Tironzi/cc2538_dev_board-main/Real_image_1.jpg

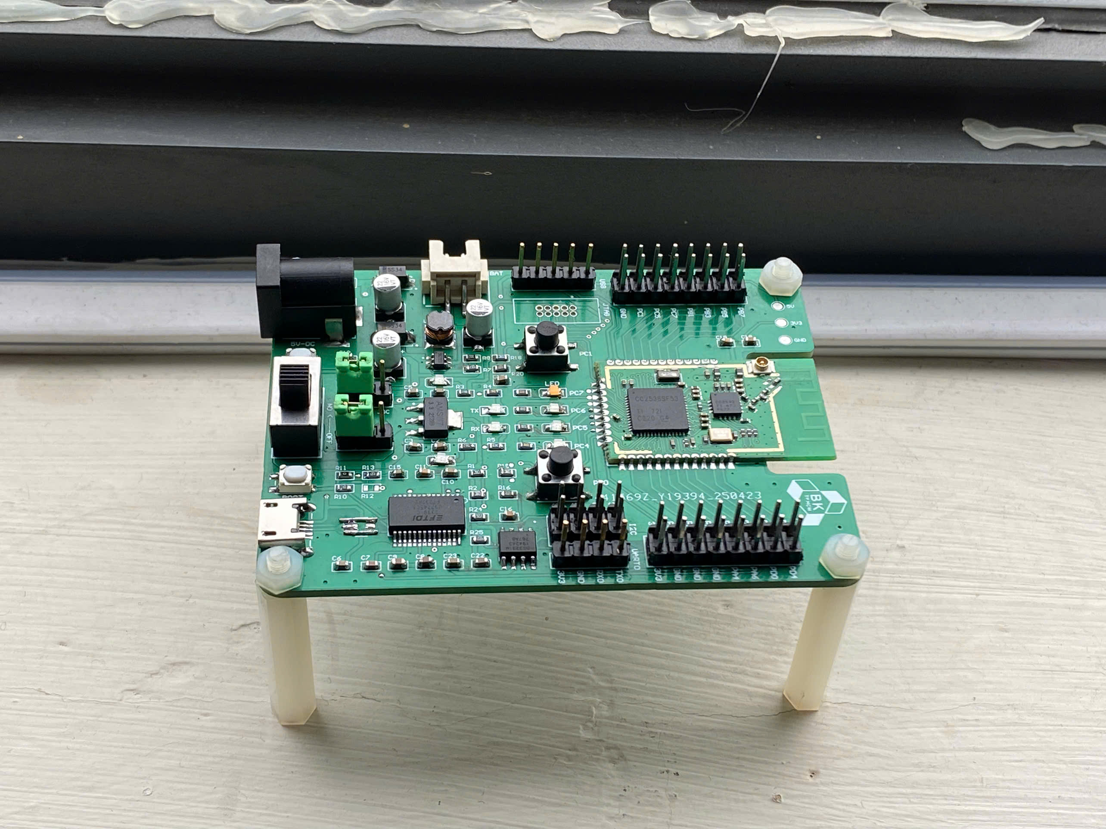
Real_image_1.jpg
