Tironzi/cc2538_dev_board-main/README.md

PROJECT DESIGN IOT HARDWARE

IoT application design and development
