Tironzi/cc2538_dev_board-main/BOM.xlsx

Comment | Description | Designator | Footprint | LibRef | Quantity
BU2032SM-BT-GTR | Battery Holder (Open) Coin, 20.0mm 1 Cell SMD (SMT) Tab | BT2 | BAT_BU2032SM-BT-GTR | BU2032SM-BT-GTR | 1 | chưa có | https://www.thegioiic.com/bs-6-de-pin-cr2032-cr2025-dan-smd
22uF | V-Chip, D4 x H5.5mm, 22uF, 16V | C1, C13, C14 | WCAP-ASLI_D4H5.5 | 865080340003 | 3 | có
1uF | CAP, size 0603, 1uF | C2, C4, C12, C18, C22, C23 | CAP_0603 | 01060310510 | 6 | chưa có | https://www.thegioiic.com/tu-gom-0603-1uf-16v
100nF | CAP, size 0603, 100nF | C3, C5, C6, C7, C9, C11, C15, C16, C17, C19 | CAP_0603 | 01060310410 | 10 | chưa có | https://www.thegioiic.com/tu-gom-0603-100nf-0-1uf-25v
4.7uF | CAP, size 0603, 4.7uF | C8, C10 | CAP_0603 | 01060310410 | 2 | chưa có | https://www.thegioiic.com/tu-gom-0603-4-7uf-10v
D Schottky | Schottky Diode | D1 | SS34 | D Schottky | 1 | có
LED SMD | LED | D2, D3, D4, D5 | LED_0805_YELLOW | LED SMD | 4 | chưa có | https://www.thegioiic.com/led-vang-0805-dan-smd-trong-suot-harvatek
SS34 | Schottky Diode, SS34 | D6 | SS34 | D Schottky | 1 | chưa có | https://www.thegioiic.com/ss34-sma-diode-schottky-3a
GREEN LED | LED | D7 | LED_0805_BLUE | LED SMD | 1 | chưa có | https://www.thegioiic.com/led-xanh-duong-0805-dan-smd-trong-suot-harvatek
RED LED | LED | D8 | LED_0805_RED | LED SMD | 1 | chưa có | https://www.thegioiic.com/led-do-0805-dan-smd-trong-suot-harvatek
BLUE LED | LED | D9 | LED_0805_PINK | LED SMD | 1 | chưa có | https://www.thegioiic.com/led-hong-0805-dan-smd-trong-suot-harvatek
PINK LED | LED | D10 | LED_0805_GREEN | LED SMD | 1 | chưa có | https://www.thegioiic.com/led-xanh-la-0805-dan-smd-trong-suot-harvatek
6V 500mA | 0805L050WR Cầu Chì Tự Phục Hồi 0805 6V 500mA | F1 | PCBComponent_1 | 0805L050WR | 1 | chưa có | https://www.thegioiic.com/0805l050wr-cau-chi-tu-phuc-hoi-0805-6v-500ma
629105150521 | Micro USB 2.0 Type B Receptacle WR-COM, Horizontal, SMT, with Pegs, High Current at Pin 1 & Pin 5 | J1 | 629105150521 | 629105150521 | 1 | có
JST 1x2 | Đầu XH2.54mm 2 Chân Dán SMD Nằm Ngang | J2 | XH 2,54M-2 SMT | JST 2.54mm 1x2 SMT | 1 | chưa có | https://www.thegioiic.com/dau-xh2-54mm-2-chan-dan-smd-nam-ngang
Jack DC | Jack DC input | JDC1 | DC-IN | Jack DC | 1 | có
Jumper | Cắm | JP1, JP5 | JP 1x3 DT | JP 1x3 2.54 Duc Thang | 2 | chưa có | https://www.thegioiic.com/jumper-2-54mm-ngan-mach-6-5mm-mau-xanh-la
JP 1x5 2.54 | Cắm | JP2 | JP 1X5 DT | JP 1x5 2.54 Duc Cong | 1 | có
JP 1x4 2.54 | Cắm | JP3 | JP 1X4 DT | JP 1x4 2.54 Duc Cong | 1 | có
JP 2x4 2.54 | Cắm | JP4 | JP 2X4 DT | JP 2x4 2.54 Duc Cong | 1 | có
JP 2x8 2.54 | Cắm | JP6, JP7 | JP 2x8 DT | JP 2x8 2.54 Duc Thang | 2 | chưa có | https://www.thegioiic.com/hang-rao-duc-doi-2-54mm-80-chan-2-hang-cao-11-2mm-xuyen-lo
22µH | WE-PD2A SMT Power Inductor, size CD43, 22µH | L1 | WE-PD2A_4532 | CD43 INDUCTOR | 1 | chưa có | https://icdayroi.com/cuon-cam-22uh-cd43 | IC đây rồi
62701021621 | WR-BHD Male Box Header, THT Straight, pitch 1.27mm, 2 row, 10 pin | P1 | 62701021621 | 62701021621 | 1 | Chưa có | https://dientuachau.com/idc-male-10p-1-27mm-1#2 | Quận 10
10k | RES, 10K Ohm, size 0603, 5%, RES, 10k Ohm, size 0603, 1% | R1, R2, R15, R18 | resistor_0603 | 0006032525, 0006031031 | 4 | có
2.5k | RES, 2.5K Ohm, size 0603, 5% | R3, R4, R5 | resistor_0603 | 0006032525 | 3 | có
5.6k | RES, 5.6k Ohm, size 0603, 1% | R6 | resistor_0603 | 0006035621 | 1 | có
22k | RES, 22k Ohm, size 0603, 1% | R7 | resistor_0603 | 0006035621 | 1 | chưa có | https://www.thegioiic.com/dien-tro-22-kohm-0603-1-
3k | RES, 3K Ohm, size 0603, 5% | R8 | resistor_0603 | 0006032525 | 1 | chưa có | https://www.thegioiic.com/dien-tro-3-kohm-0603-1-
1k | RES, 1k Ohm, size 0603, 1% | R9, R10, R14, R17, R19, R21 | resistor_0603 | 0006031031 | 6 | có
0 | RES, 0 Ohm, size 0603, 1% | R11, R12 | resistor_0603 | 0006030001 | 2 | có
220 | RES, 220 Ohm, size 0603, 1% | R13, R16, R20 | resistor_0603 | 0006031031 | 3 | có
4.7k | RES, 4.7k Ohm, size 0603, 1% | R24, R25 | resistor_0603 | 0006031031 | 2 | chưa có | https://www.thegioiic.com/dien-tro-4-7-kohm-0603-1-
Tactile_Switch_4.2x3.3mm | Nút Nhấn 4.2x3.3mm Cao 2.5mm 4 Chân SMD V1 | S1, S2 | TACTILE_BUTTON_4.3X3.3 | Tactile_Switch_4.2x3.3mm | 2 | chưa có | https://www.thegioiic.com/nut-nhan-4-2x3-3mm-cao-2-5mm-4-chan-smd-v2
Tactile_Switch_6x6 | Tactile Switch, 6x6mm | S3, S4 | Tactile_Switch_6x6 | Tactile_Switch_6x6 | 2 | chưa có | https://www.thegioiic.com/nut-nhan-6x6mm-cao-6mm-4-chan-smd
SS-12D10 | SS-12D10 Công Tắc Trượt 3 Chân Xuyên Lỗ ON-OFF 1P2T 0.5A | SW1 | Slide Switch | SS-12D10 | 1 | chưa có | https://www.thegioiic.com/ss-12d10-cong-tac-truot-3-chan-xuyen-lo-on-off-1p2t-0-5a
Test_Point | Test point, 2mm radius | TP1, TP2, TP3 | TP_2MM | Test_Point | 3 | Ko cần
AMS1117-3.3V | AMS1117-3.3V, OUT 3.3V 1A. | U1 | AMS1117-3.3V SOT223 | AMS1117-3.3V | 1 | Chưa có | https://www.thegioiic.com/ams1117-3-3v-ic-on-ap-3-3v-1a-sot-223
INTERFACE-FT232RL(SSOP28) | USB Bridge, USB to UART USB 2.0 UART Interface 28-SSOP | U2 | SSOP28-0.65-10.2X5.2MM | INTERFACE-FT232RL(SSOP28) | 1 | Chưa có | https://www.thegioiic.com/ft232rl-ic-usb-to-serial-uart-28-ssop
USBLC6-2SC6 | 17V Clamp 5A (8/20Âµs) Ipp Tvs Diode Surface Mount SOT-23-6 | U3 | SOT95P280X145-6N | USBLC6-2SC6 | 1 | Chưa có | https://icdayroi.com/usblc6-2sc6-tvs-diode-5-25v-17v-sot23-6 | IC đây rồi
MT3608 | High Efficiency 1.2MHz2A Step Up Converter | U4 | SOT95P280X145-6N | MT3608 | 1 | chưa có | https://www.thegioiic.com/mt3608-ic-dieu-chinh-tang-ap-2a-sot-23-6
CC253+CC2592 | WAVGAT CC2538 + CC2592 module Communication distance Support zigbee/6lowpan | U5 | CC2538_V1 | CC253+CC2592 | 1 | Có
DS3231MZ+ | Â±5ppm, I2C Real-Time Clock | U7 | SOIC127P600X175-8N | DS3231MZ+ | 1 | Chưa có | https://www.thegioiic.com/ds3231mz-ic-rtc-clock-calendar-i2c-8-soic
