Tironzi/cc2538_dev_board-main/(list of files, drawings)

Other design files:
ZIGBEE_CC2538+2592/[01] - COVER PAGE.SchDoc
ZIGBEE_CC2538+2592/[02] - BLOCK DIAGRAM.SchDoc
ZIGBEE_CC2538+2592/[03] - POWER DIAGRAM.SchDoc
ZIGBEE_CC2538+2592/[04] - CC2538+CC2592.SchDoc
ZIGBEE_CC2538+2592/[05] - RTC.SchDoc
ZIGBEE_CC2538+2592/ZIGBEE_CC2538+2592.PrjPcb
